raywall/lowcost-braille-printer/software/windows/Braille Printer Text Editor/Resources/controles.jpg

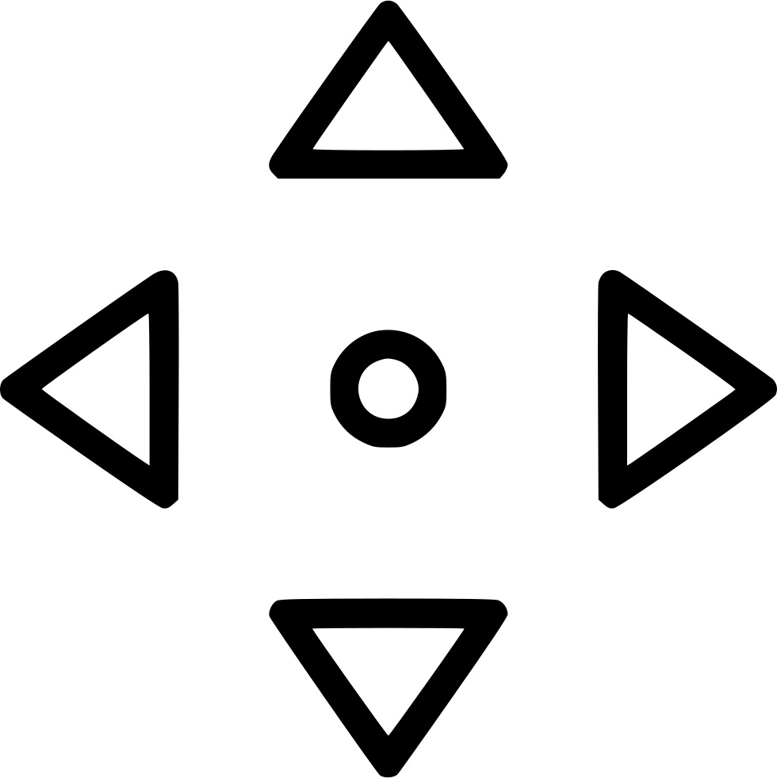
software/windows/Braille Printer Text Editor/Resources/controles.jpg
