raywall/lowcost-braille-printer/software/windows/Braille Printer Text Editor/Resources/updown.jpg

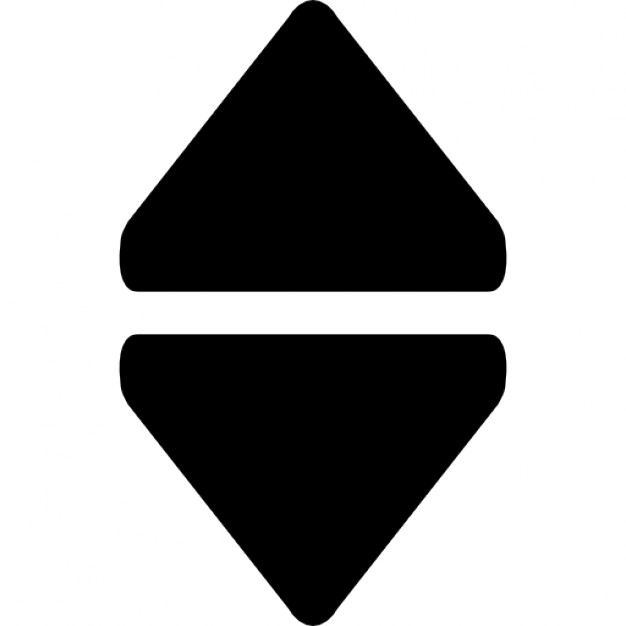
software/windows/Braille Printer Text Editor/Resources/updown.jpg
