raywall/lowcost-braille-printer/(commit log)

2026-05-05 Braille Print Server
2026-05-08 driver printer for macos and windows
2026-05-16 ajustes de performance, correção de bugs e melhorias do driver
    [DataFunctions.h, Functions.h, firmware.ino]
